max-bold/car_sniffer/AIN.png

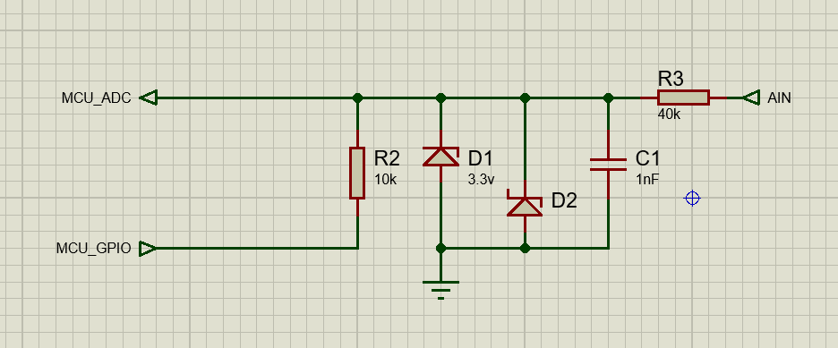
AIN.png
