max-bold/car_sniffer/docs/analog-input-biased.png

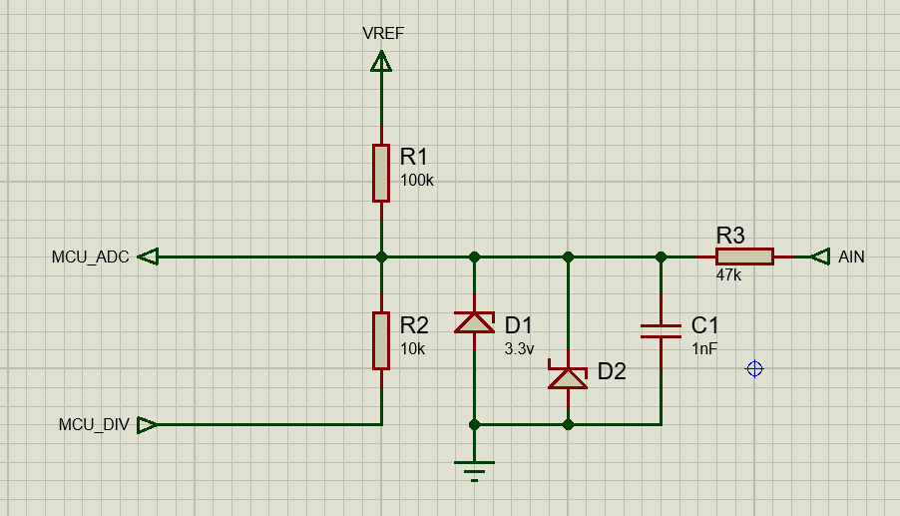
docs/analog-input-biased.png
