max-bold/car_sniffer/docs/gui-com8.png

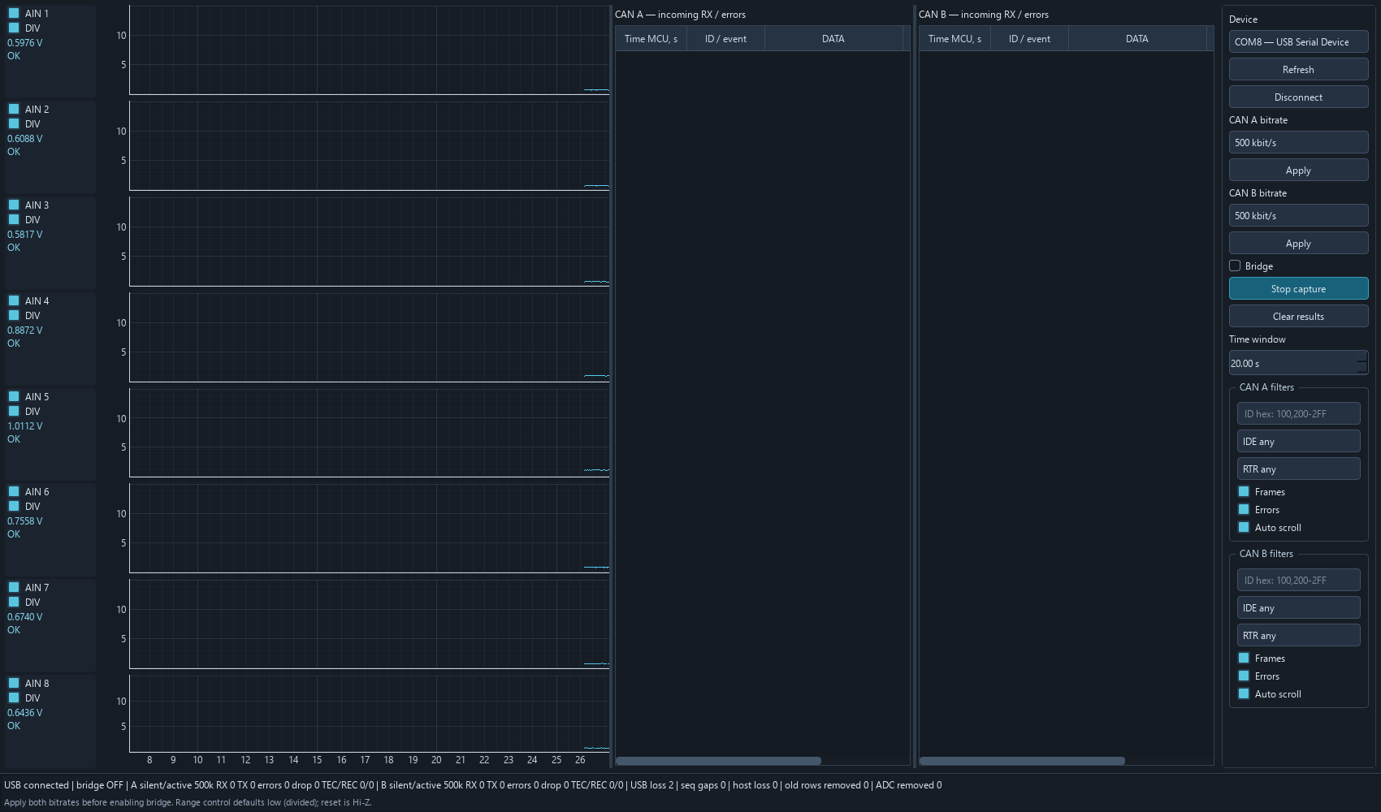
docs/gui-com8.png
