max-bold/car_sniffer/docs/gui-demo.png

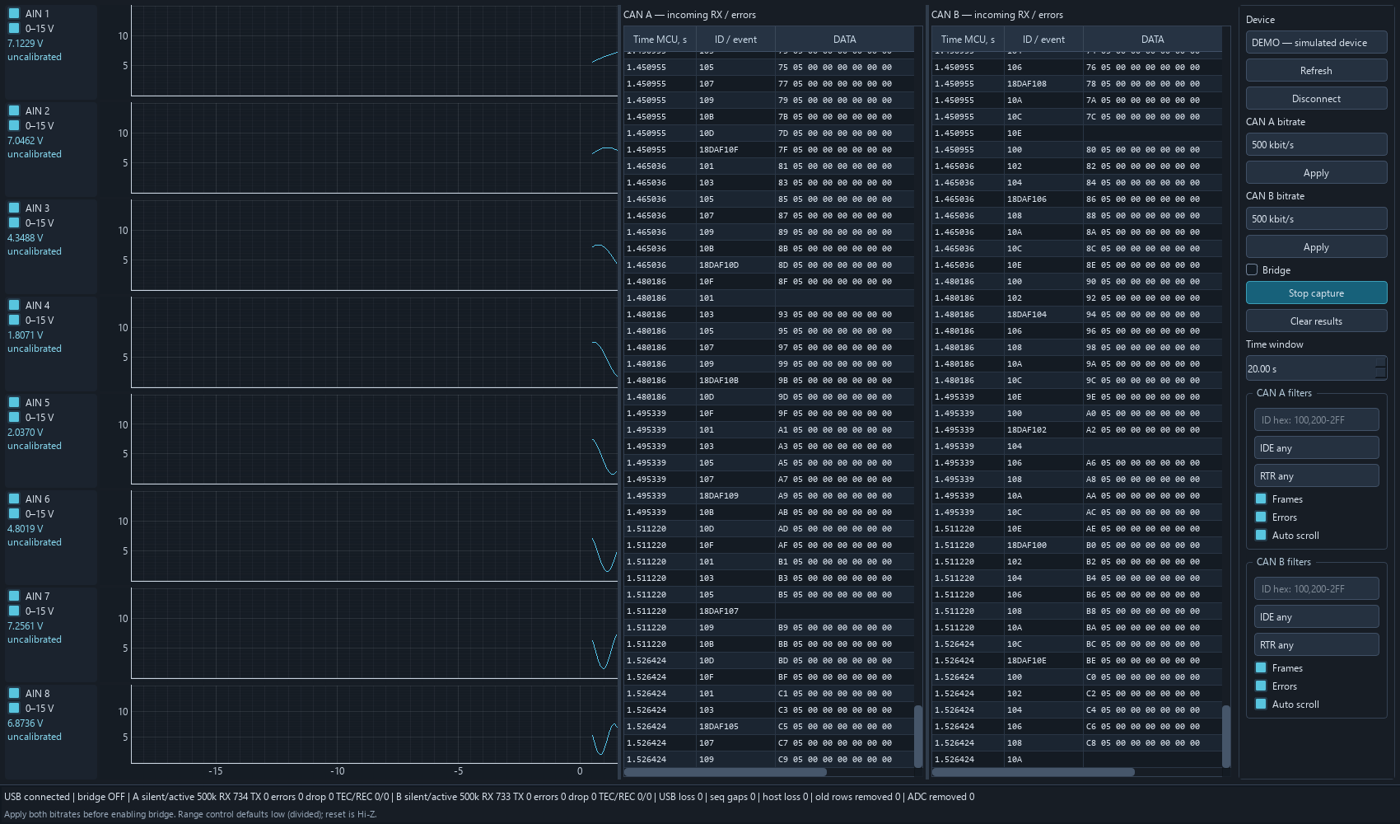
docs/gui-demo.png
