max-bold/car_sniffer/docs/calibration-current.png

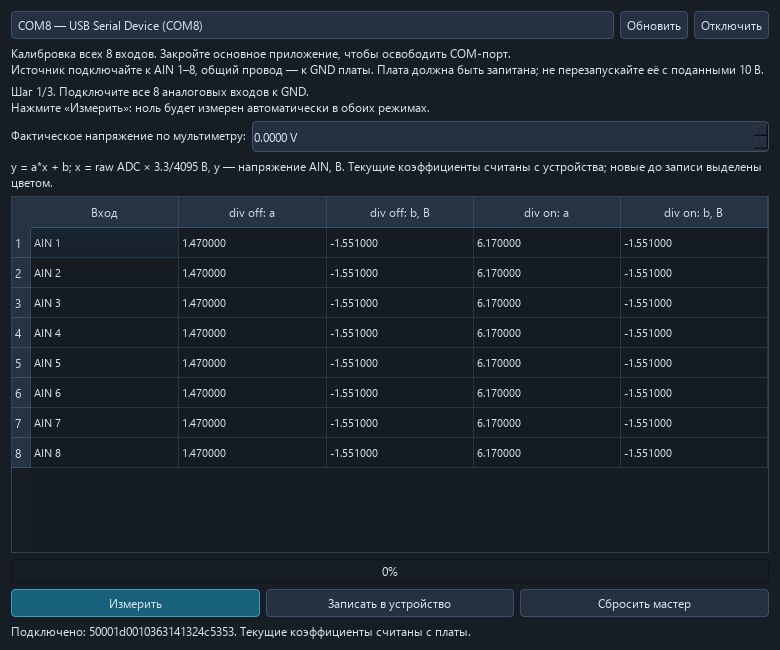
docs/calibration-current.png
