max-bold/car_sniffer/(list of files, drawings)

Other design files:
Car Sniffer.pdsprj
Project Backups/Car Sniffer [20261007, 15-31-30].pdsprj
Project Backups/Car Sniffer [20261007, 18-26-01].pdsprj
Project Backups/Car Sniffer [20261008, 13-15-57].pdsprj
Project Backups/Car Sniffer [20261010, 16-24-42].pdsprj
