max-bold/car_sniffer/(commit log)

2026-10-10 Add Car Sniffer firmware, desktop application and project documentation
    [Car Sniffer [20261007, 15-31-30].pdsprj, Car Sniffer [20261007, 18-26-01].pdsprj, Car Sniffer [20261008, 13-15-57].pdsprj, Car Sniffer.pdsprj]
2026-10-10 Move calibration to standalone wizard and persist device coefficients
    [Car Sniffer [20261010, 16-24-42].pdsprj, Car Sniffer.pdsprj]
2026-10-18 Use fixed analog divider and simplify device calibration
    [backend.py, board.h, calibrate.py, calibration.py, calibration_flash.c, core_test.c, engine.c]
